sfambach/XT-AT-PC-RGB-LED/hardware/v2/v2-bottom.png

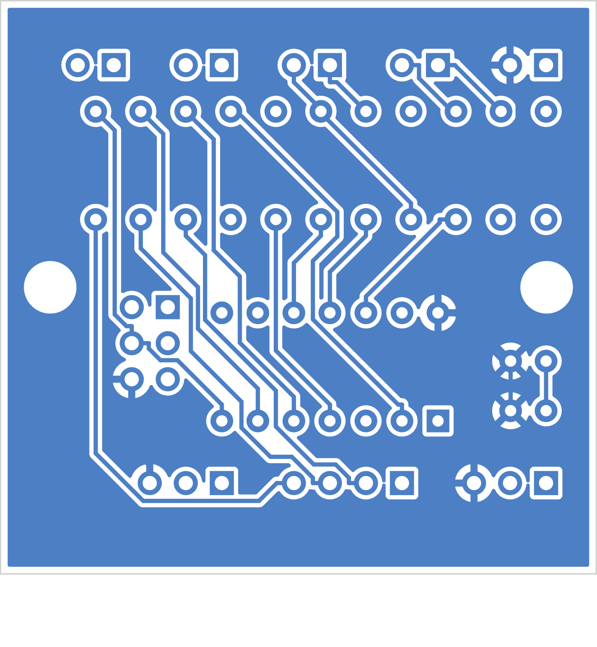
hardware/v2/v2-bottom.png
