sfambach/XT-AT-PC-RGB-LED/hardware/v2/v2-top.png

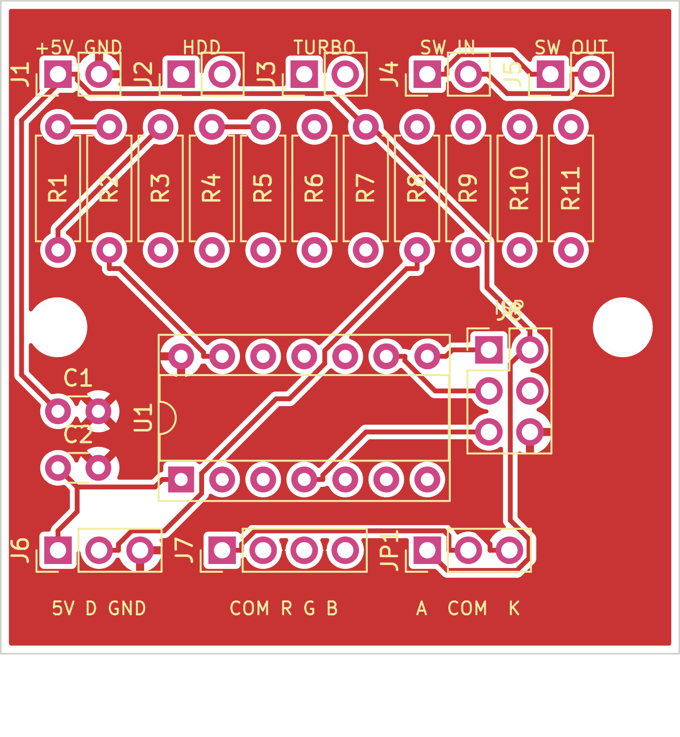
hardware/v2/v2-top.png
