sfambach/XT-AT-PC-RGB-LED/sim/three_states_tran.png

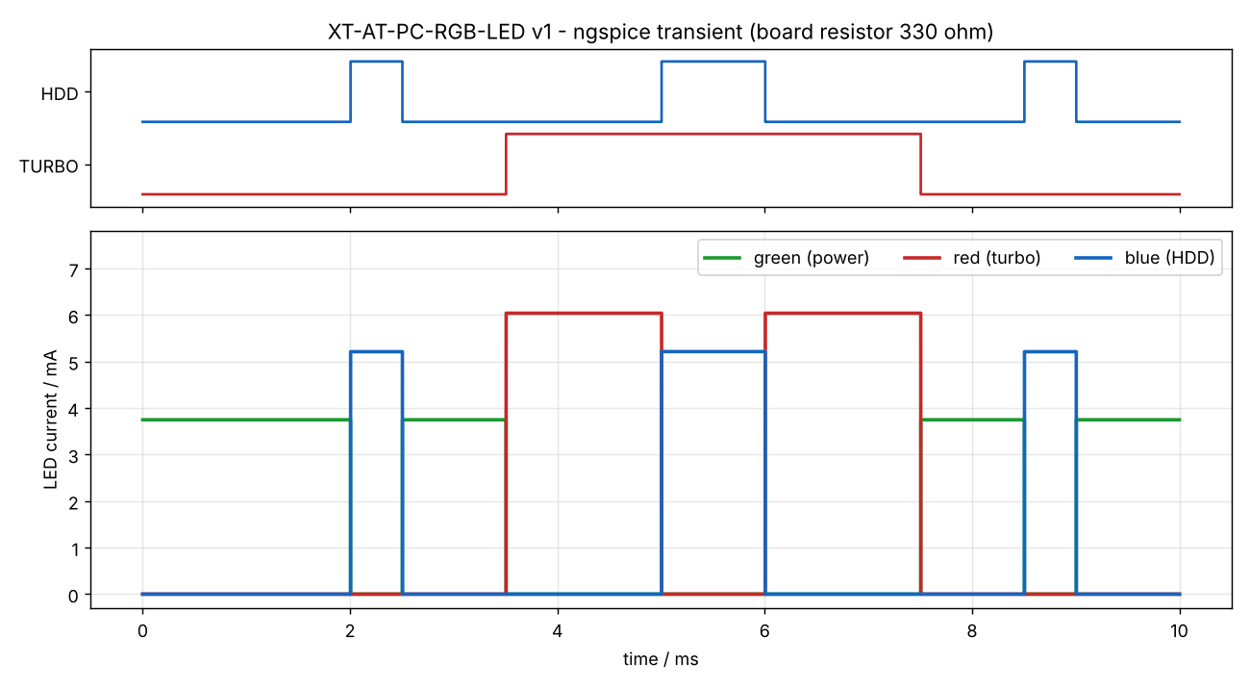
sim/three_states_tran.png
