sfambach/XT-AT-PC-RGB-LED/hardware/v2/xt-at-pc-rgb-led-v2-schematic.pdf

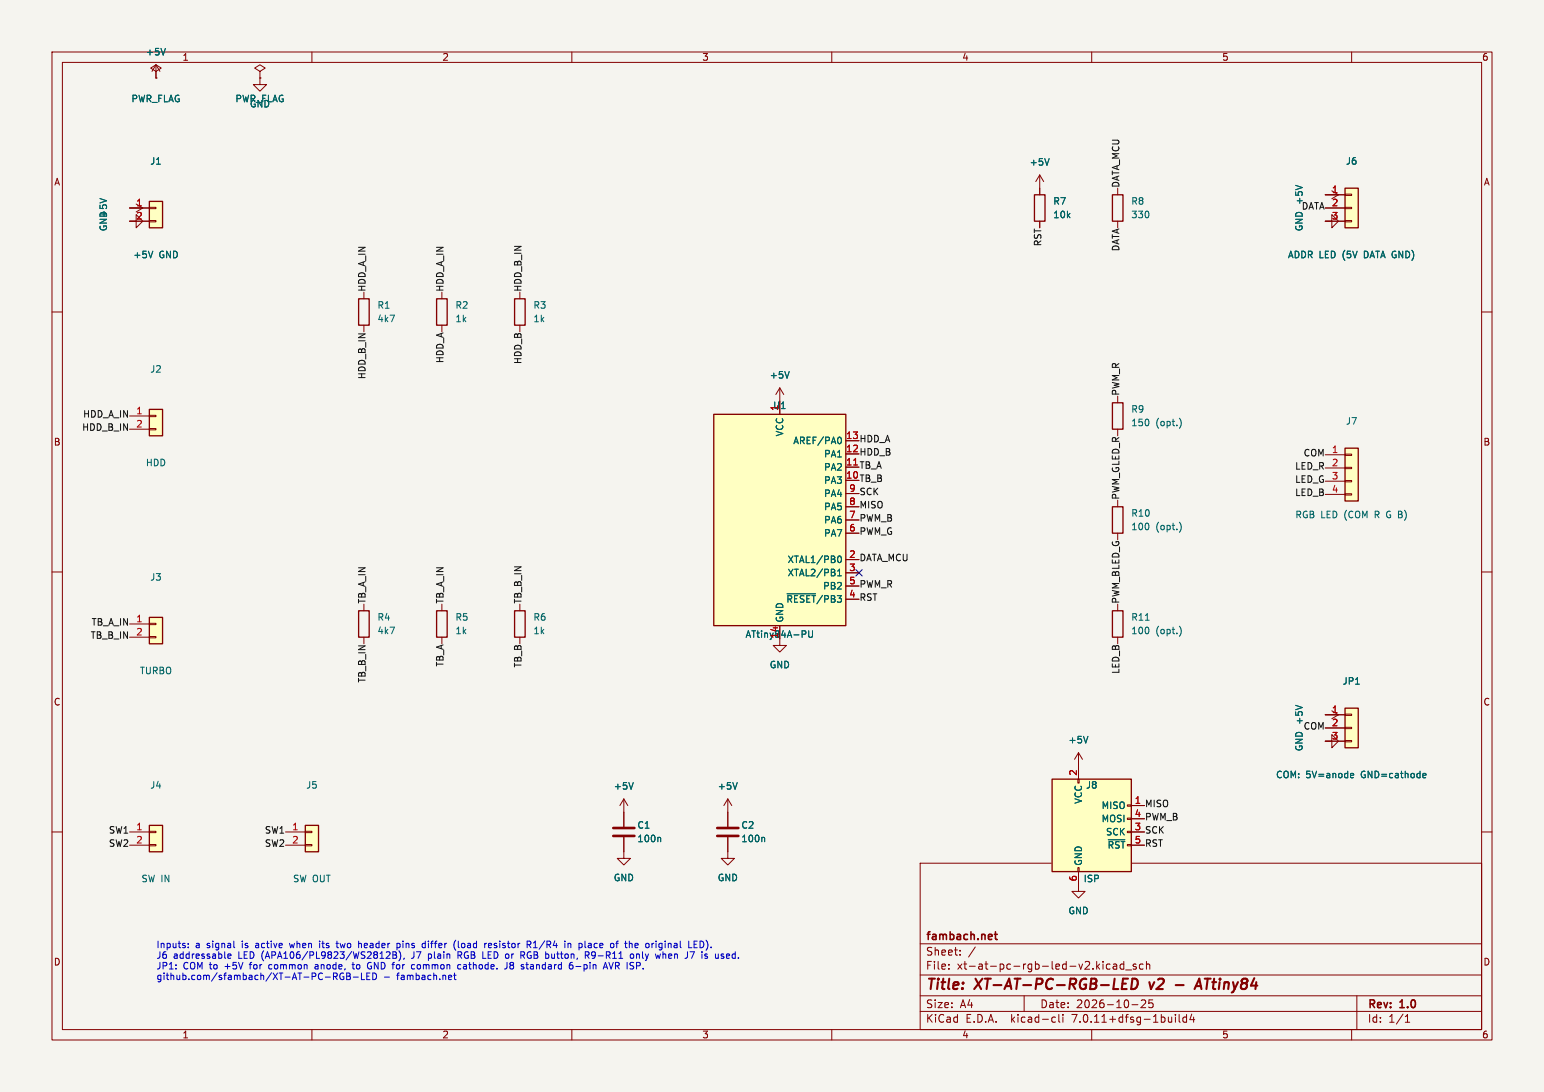
[picture p7: page 1]

J6 ADDR LED (5V DATA GND) +5V GND

J6 ADDR LED (5V DATA GND) 1

U1 ATtiny84A-PU VCC
File: xt-at-pc-rgb-led-v2.kicad_sch Sheet: / fambach.net VCC
TB_A HDD_B DATA_MCU

1 PA3 10 PA2 11 PA1 12 AREF/PA0 13 GND 14 XTAL1/PB0 2 XTAL2/PB1 3 ~{RESET}/PB34 PB2 5 PA7 6 PA6 7 PA5 8 PA4 9 U1 ATtiny84A-PU

2 SCK 3 MOSI 4 ~{RST}5 GND
ISP MISO VCC
