sfambach/XT-AT-PC-RGB-LED/hardware/v1/xt-at-pc-rgb-led-v1-schematic.pdf

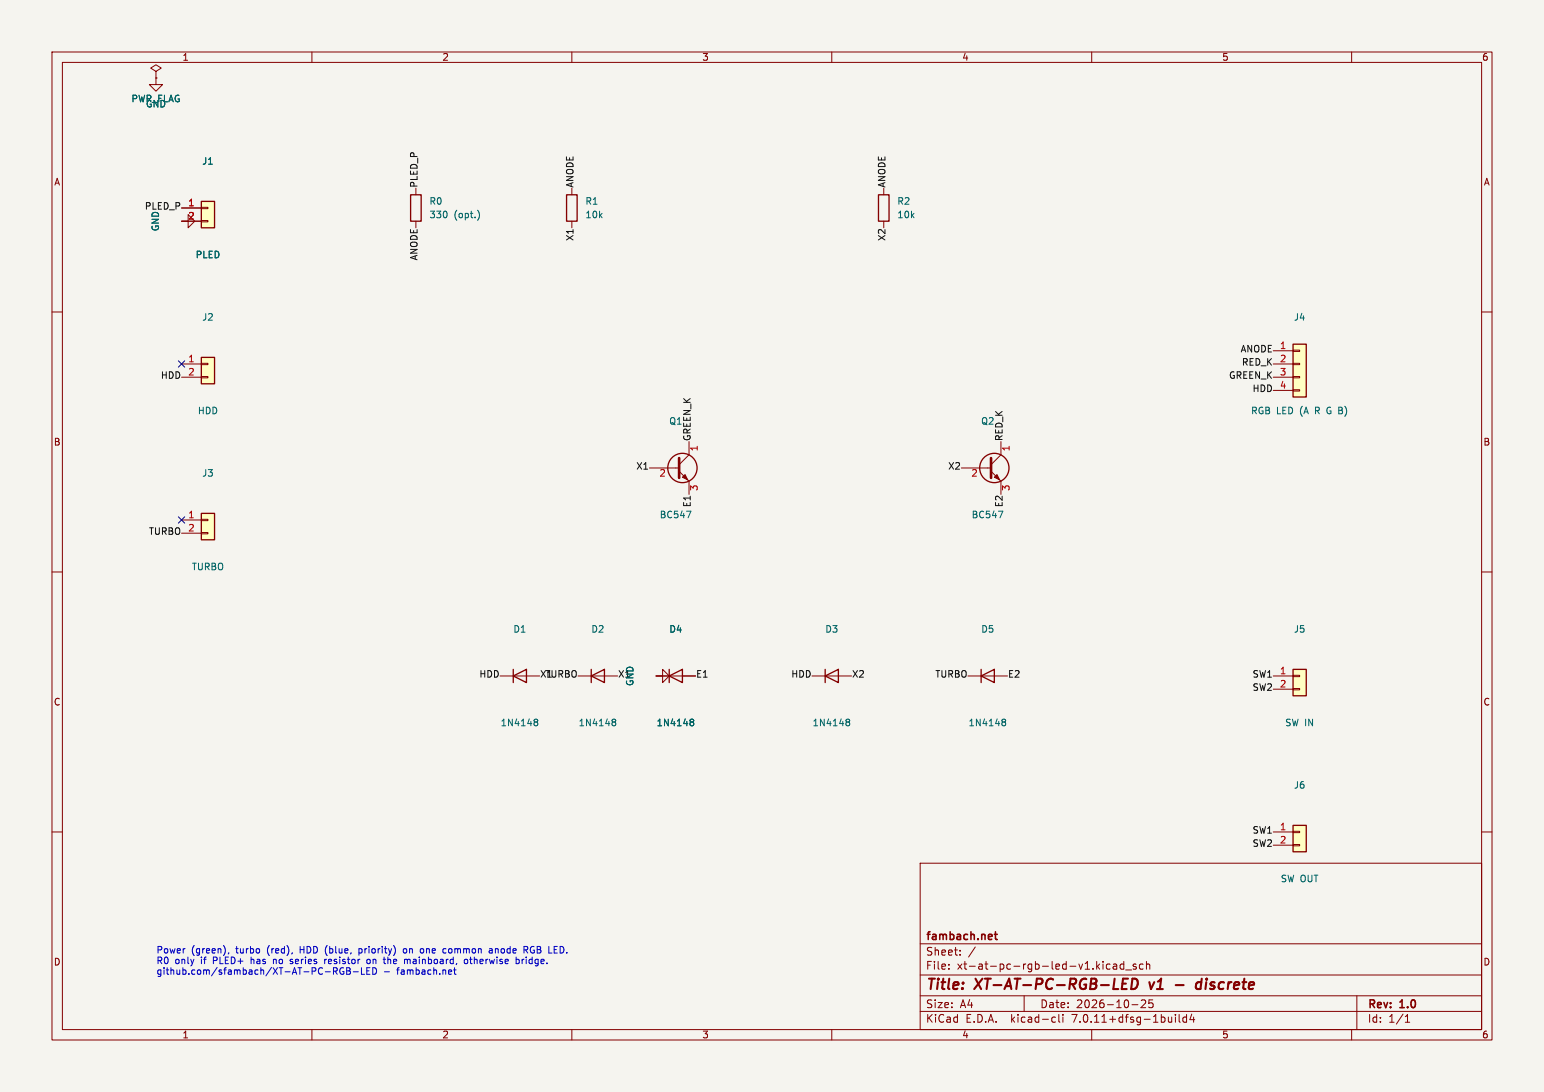
[picture p8: page 1]

File: xt-at-pc-rgb-led-v1.kicad_sch Sheet: / fambach.net D3
