sfambach/XT-AT-PC-RGB-LED/hardware/v2/xt-at-pc-rgb-led-v2.kicad_pcb

## KiCad design hardware/v2/xt-at-pc-rgb-led-v2.kicad_pcb (2026-10-25)

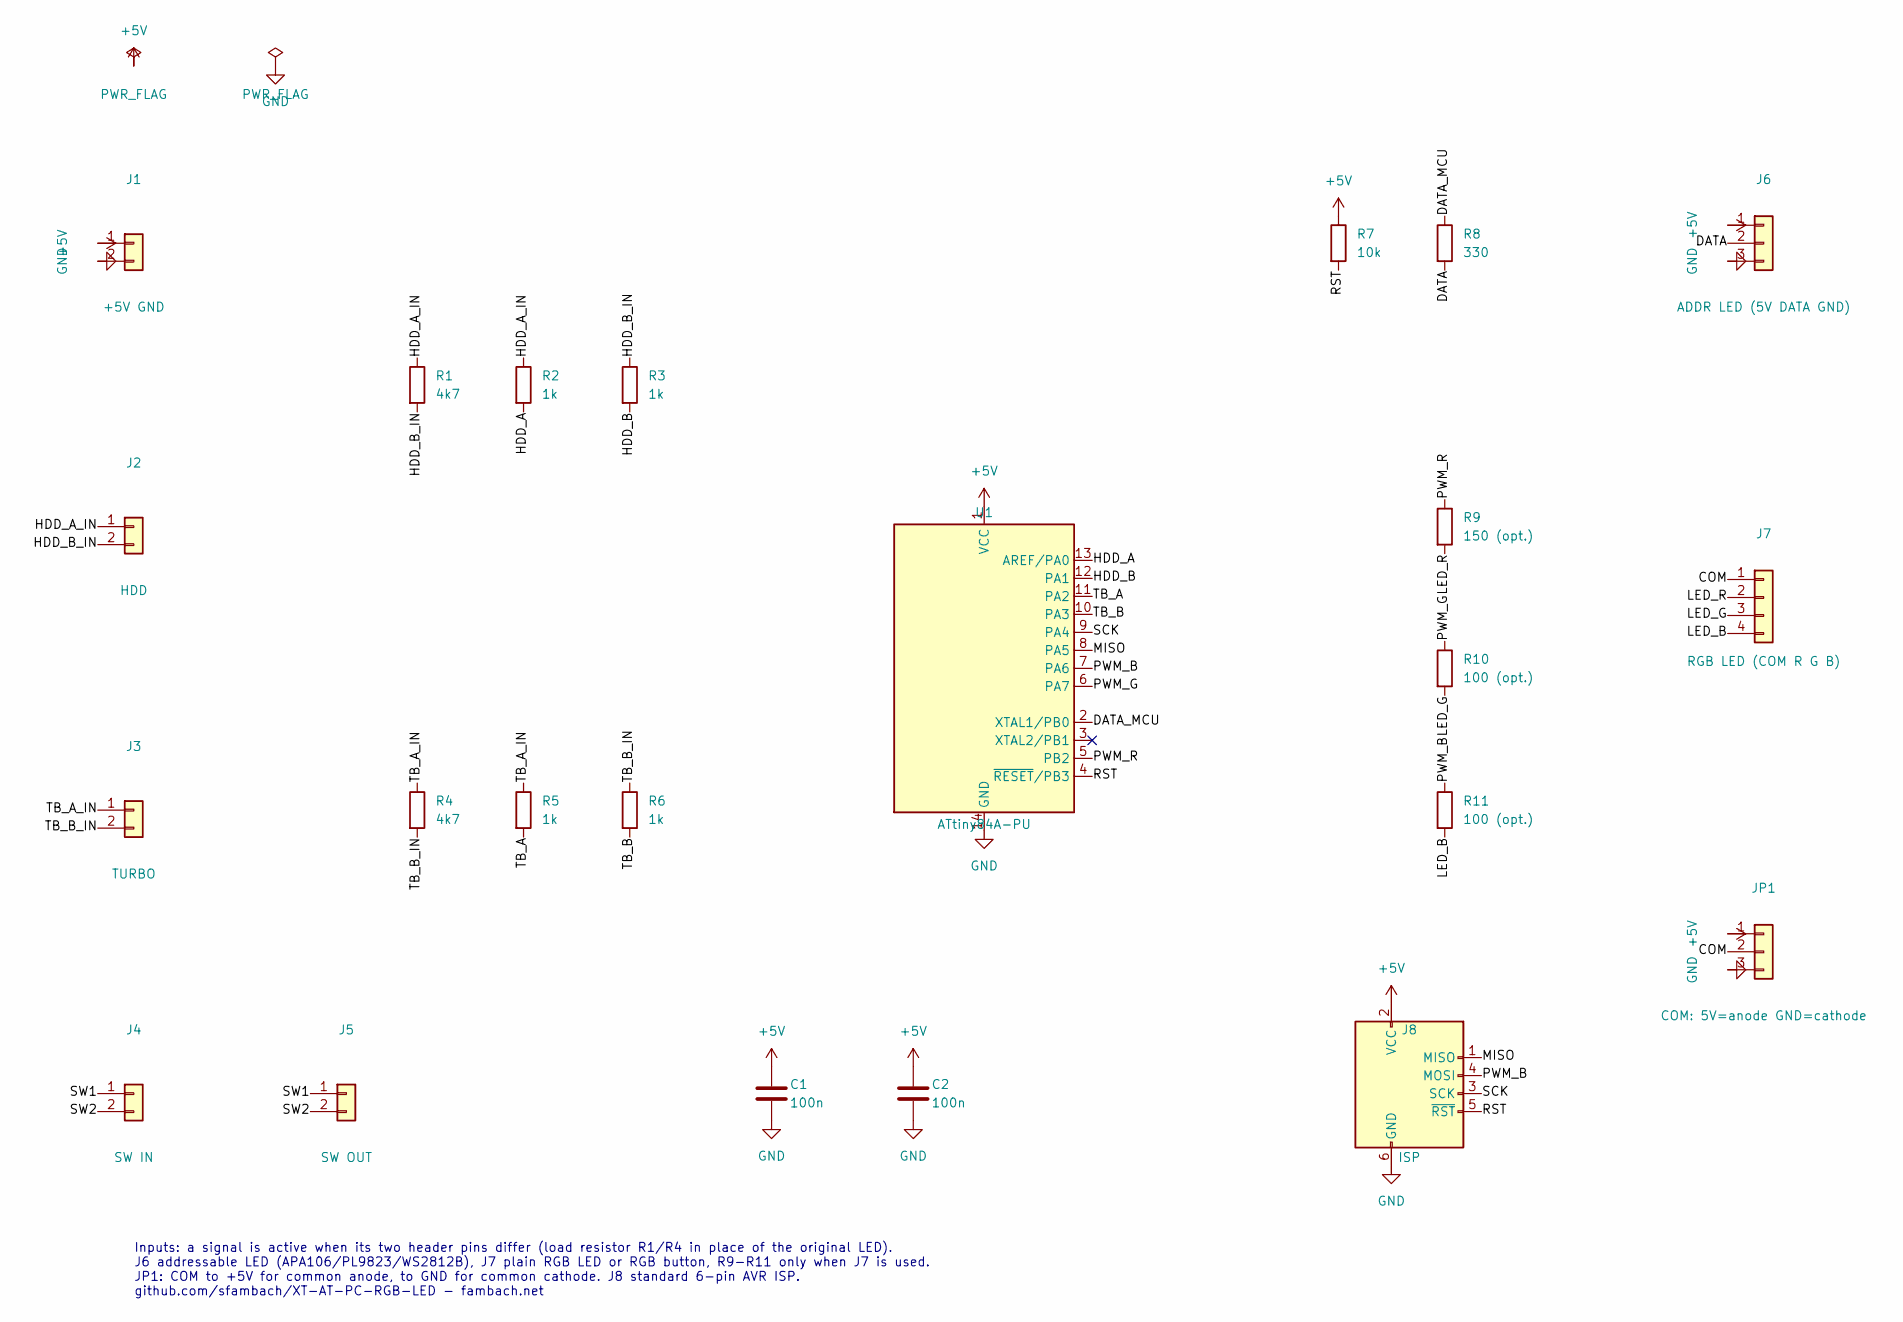
[picture p9: schematic xt-at-pc-rgb-led-v2.kicad_sch, XT-AT-PC-RGB-LED v2 - ATtiny84]

Parts:
C1, C2: 100n; C_Disc_D3.0mm_W1.6mm_P2.50mm
J1: +5V GND; PinHeader_1x02_P2.54mm_Vertical
J2: HDD; PinHeader_1x02_P2.54mm_Vertical
J3: TURBO; PinHeader_1x02_P2.54mm_Vertical
J4: SW IN; PinHeader_1x02_P2.54mm_Vertical
J5: SW OUT; PinHeader_1x02_P2.54mm_Vertical
J6: ADDR LED (5V DATA GND); PinHeader_1x03_P2.54mm_Vertical
J7: RGB LED (COM R G B); PinHeader_1x04_P2.54mm_Vertical
J8: ISP; PinHeader_2x03_P2.54mm_Vertical
JP1: COM: 5V=anode GND=cathode; PinHeader_1x03_P2.54mm_Vertical
R1, R4: 4k7; R_Axial_DIN0207_L6.3mm_D2.5mm_P7.62mm_Horizontal
R2, R3, R5, R6: 1k; R_Axial_DIN0207_L6.3mm_D2.5mm_P7.62mm_Horizontal
R7: 10k; R_Axial_DIN0207_L6.3mm_D2.5mm_P7.62mm_Horizontal
R8: 330; R_Axial_DIN0207_L6.3mm_D2.5mm_P7.62mm_Horizontal
R9: 150 (opt.); R_Axial_DIN0207_L6.3mm_D2.5mm_P7.62mm_Horizontal
R10, R11: 100 (opt.); R_Axial_DIN0207_L6.3mm_D2.5mm_P7.62mm_Horizontal
U1: ATtiny84A-PU; DIP-14_W7.62mm_Socket

Connections:
+5V: C1.1, C2.1, J1.1, J6.1, J8.2 (VCC), JP1.1, R7.1, U1.1 (VCC)
/COM: J7.1, JP1.2
/DATA: J6.2, R8.2
/DATA_MCU: R8.1, U1.2 (XTAL1/PB0)
/HDD_A: R2.2, U1.13 (AREF/PA0)
/HDD_A_IN: J2.1, R1.1, R2.1
/HDD_B: R3.2, U1.12 (PA1)
/HDD_B_IN: J2.2, R1.2, R3.1
/LED_B: J7.4, R11.2
/LED_G: J7.3, R10.2
/LED_R: J7.2, R9.2
/MISO: J8.1 (MISO), U1.8 (PA5)
/PWM_B: J8.4 (MOSI), R11.1, U1.7 (PA6)
/PWM_G: R10.1, U1.6 (PA7)
/PWM_R: R9.1, U1.5 (PB2)
/RST: J8.5 (~RST), R7.2, U1.4 (~RESET/PB3)
/SCK: J8.3 (SCK), U1.9 (PA4)
/SW1: J4.1, J5.1
/SW2: J4.2, J5.2
/TB_A: R5.2, U1.11 (PA2)
/TB_A_IN: J3.1, R4.1, R5.1
/TB_B: R6.2, U1.10 (PA3)
/TB_B_IN: J3.2, R4.2, R6.1
GND: C1.2, C2.2, J1.2, J6.3, J8.6 (GND), JP1.3, U1.14 (GND)

Notes on the sheet:
Inputs: a signal is active when its two header pins differ (load resistor R1/R4 in place of the original LED). J6 addressable LED (APA106/PL9823/WS2812B), J7 plain RGB LED or RGB button, R9-R11 only when J7 is used. JP1: COM to +5V for common anode, to GND for common cathode. J8 standard 6-pin AVR 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

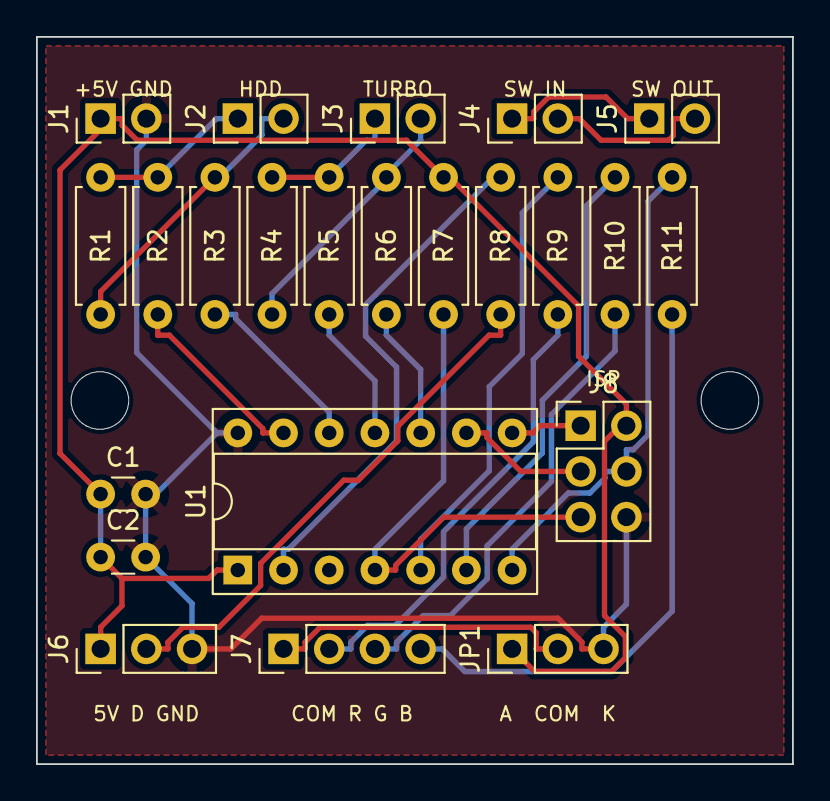
[picture p10: board xt-at-pc-rgb-led-v2.kicad_pcb from above]

Board: 2 copper layers, 42.0 x 40.4 mm, 25 parts (0 on the bottom side), 24 nets.

Other parts of the board:
H1, H2: M3; MountingHole_3.2mm_M3
