sfambach/XT-AT-PC-RGB-LED/hardware/v1/xt-at-pc-rgb-led-v1.kicad_pcb

## KiCad design hardware/v1/xt-at-pc-rgb-led-v1.kicad_pcb (2026-10-25, an earlier design)

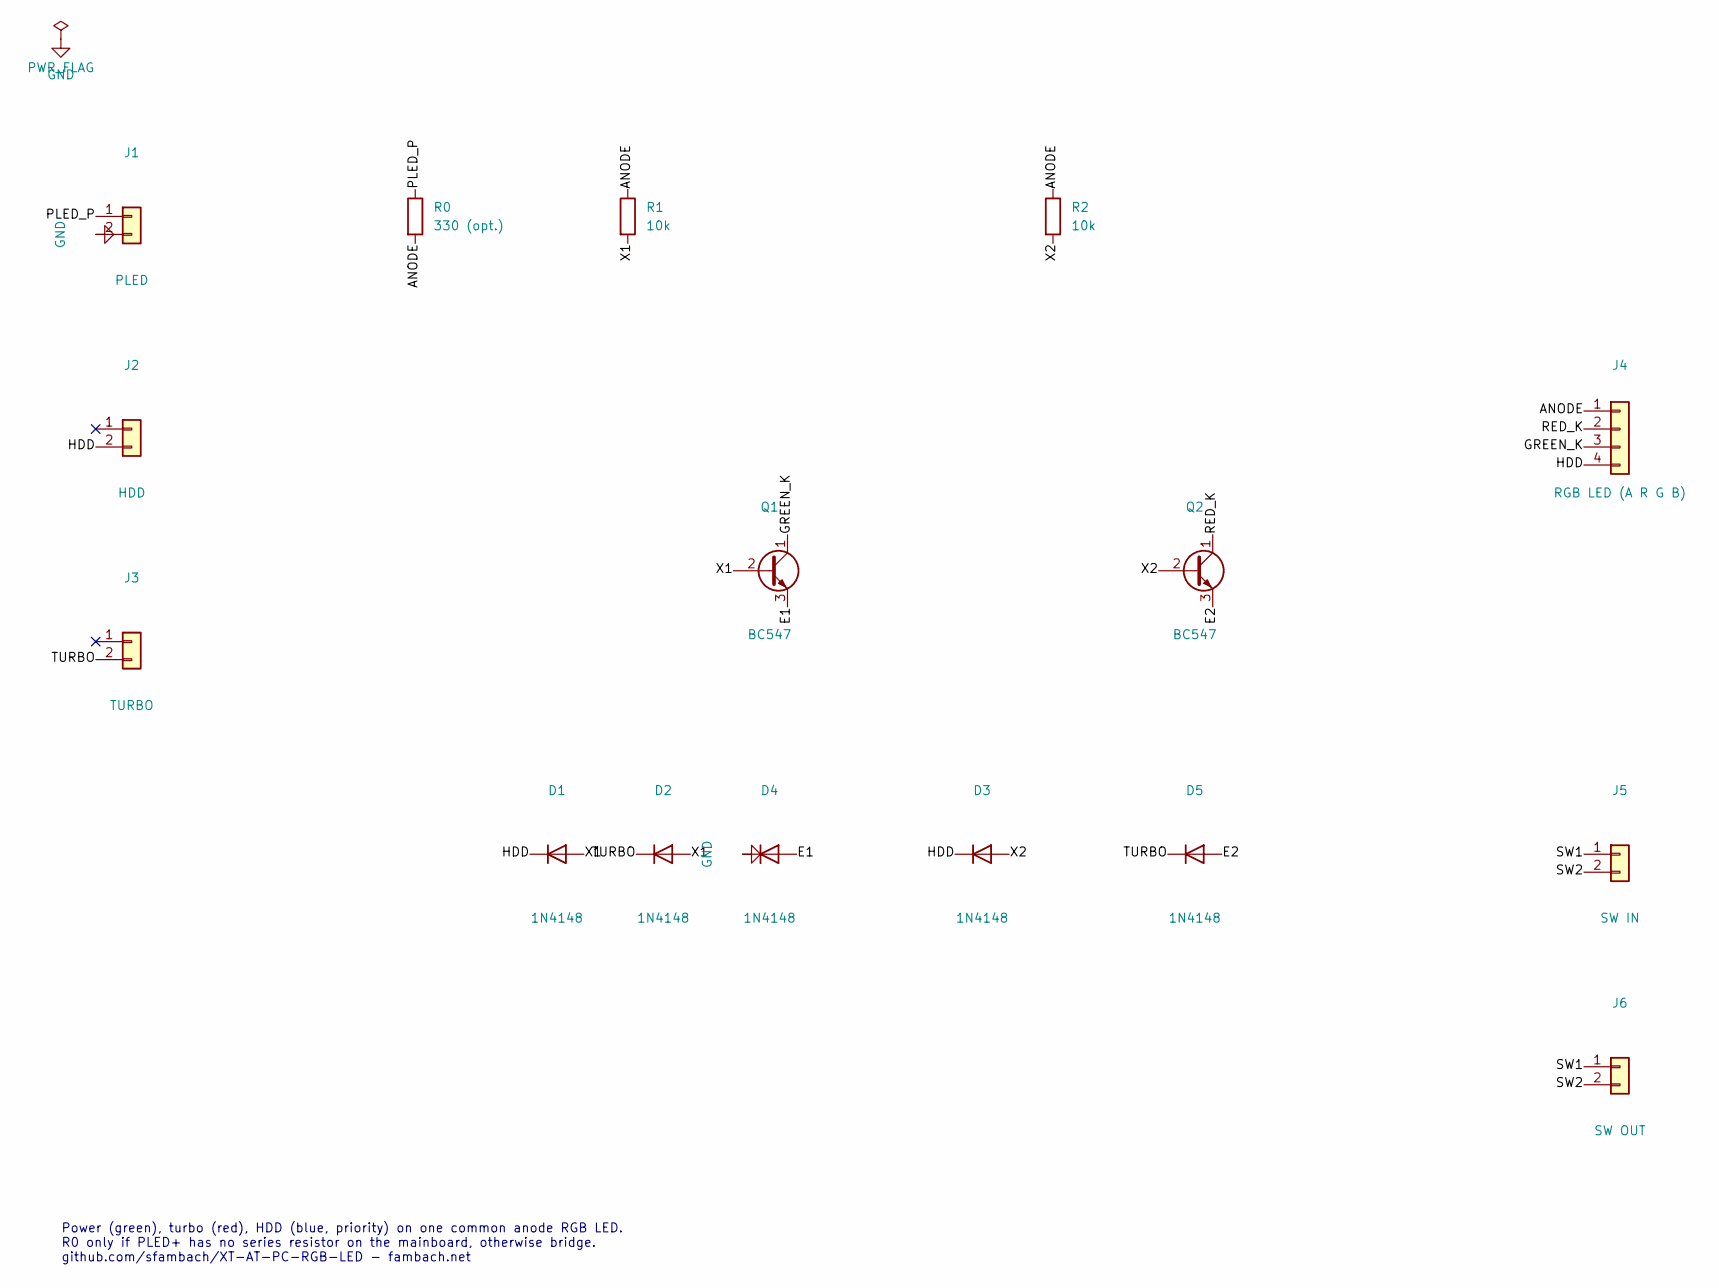
[picture p11: schematic xt-at-pc-rgb-led-v1.kicad_sch, XT-AT-PC-RGB-LED v1 - discrete]

Parts:
D1, D2, D3, D4, D5: 1N4148; D_DO-35_SOD27_P7.62mm_Horizontal
J1: PLED; PinHeader_1x02_P2.54mm_Vertical
J2: HDD; PinHeader_1x02_P2.54mm_Vertical
J3: TURBO; PinHeader_1x02_P2.54mm_Vertical
J4: RGB LED (A R G B); PinHeader_1x04_P2.54mm_Vertical
J5: SW IN; PinHeader_1x02_P2.54mm_Vertical
J6: SW OUT; PinHeader_1x02_P2.54mm_Vertical
Q1, Q2: BC547; TO-92_Inline_Wide
R0: 330 (opt.); R_Axial_DIN0207_L6.3mm_D2.5mm_P7.62mm_Horizontal
R1, R2: 10k; R_Axial_DIN0207_L6.3mm_D2.5mm_P7.62mm_Horizontal

Connections:
/ANODE: J4.1, R0.2, R1.1, R2.1
/E1: D4.2 (A), Q1.3 (E)
/E2: D5.2 (A), Q2.3 (E)
/GREEN_K: J4.3, Q1.1 (C)
/HDD: D1.1 (K), D3.1 (K), J2.2, J4.4
/PLED_P: J1.1, R0.1
/RED_K: J4.2, Q2.1 (C)
/SW1: J5.1, J6.1
/SW2: J5.2, J6.2
/TURBO: D2.1 (K), D5.1 (K), J3.2
/X1: D1.2 (A), D2.2 (A), Q1.2 (B), R1.2
/X2: D3.2 (A), Q2.2 (B), R2.2
GND: D4.1 (K), J1.2

Notes on the sheet:
Power (green), turbo (red), HDD (blue, priority) on one common anode RGB LED. R0 only if PLED+ has no series resistor on the mainboard, otherwise bridge. github.com/sfambach/XT-AT-PC-RGB-LED - fambach.net

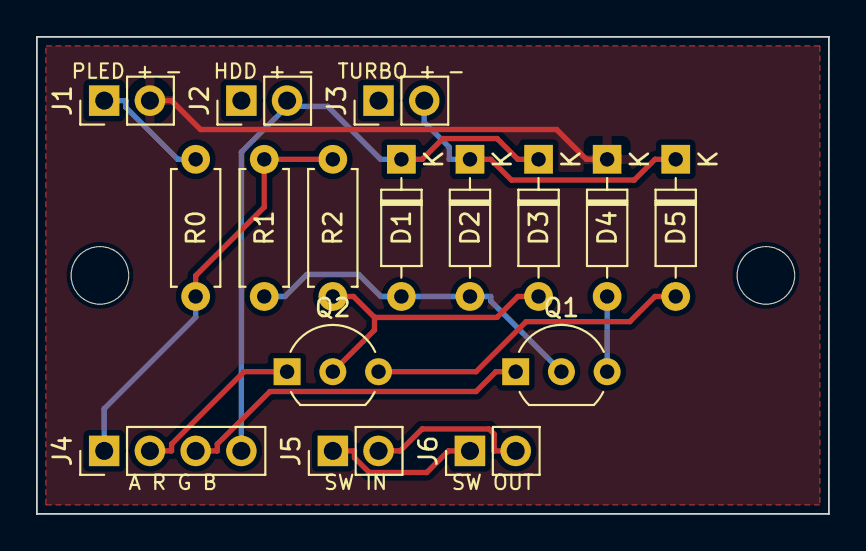
[picture p12: board xt-at-pc-rgb-led-v1.kicad_pcb from above]

Board: 2 copper layers, 44.0 x 26.5 mm, 18 parts (0 on the bottom side), 13 nets.

Other parts of the board:
H1, H2: M3; MountingHole_3.2mm_M3
