sfambach/XT-AT-PC-RGB-LED/(commit log)

2026-10-25 Add RGB status LED v1 circuit and v2 ATtiny85 firmware
    v1: one common anode RGB LED for power (green), turbo (red) and HDD
    (blue, priority) with two NPN transistors, five diodes and two resistors,
    ngspice simulations included.
    v2: ATtiny85 driving an addressable RGB LED, polarity independent header
    inputs, EEPROM configuration built from config.ini.
    Claude-Session: https://claude.ai/code/session_01JRatMm8Q7Nvo5CN8dD4gBk
2026-10-25 v2: add plain RGB output (ATtiny84 PWM) and switch notes
    ATtiny84 build drives an addressable LED and a plain common anode or
    common cathode RGB LED / RGB button at the same time. Config version 2
    adds rgb_output. README describes both LED outputs, button vs. latching
    switch (ATX, ATX-to-AT adapter) and the ATtiny84 pinout.
    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
2026-10-25 Add v1 and v2 boards, transient simulation
    KiCad 7 boards generated from Python (hardware/generator), routed with
    Freerouting: v1 discrete 48 x 22.5 mm, v2 ATtiny84 DIP-14 with 6-pin
    AVR ISP, addressable and plain RGB output, 54.5 x 33 mm. Both with two
    M3 holes on the long axis. Gerber, schematic PDF, renders and DRC
    reports included. Transient ngspice simulation with plot script.
    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
    [xt-at-pc-rgb-led-v1.kicad_pcb, xt-at-pc-rgb-led-v1.kicad_sch, xt-at-pc-rgb-led-v2.kicad_pcb, xt-at-pc-rgb-led-v2.kicad_sch]
2026-10-25 Add 2D dimension drawings and project history
    Top, front and side view per board, generated from the PCB, with the
    assumed component heights stated. README gets a short history with the
    key decisions.
    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
2026-10-25 v2: mounting holes between parts, board 42.5 x 33 mm
    C2 and R11 moved so the M3 holes fit between the parts; board width
    54.5 -> 42.5 mm. Dimension drawings assume standing resistors (about
    11 mm height).
    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
    [xt-at-pc-rgb-led-v2.kicad_pcb, xt-at-pc-rgb-led-v2.kicad_sch]
2026-10-25 Lay resistors and diodes flat on both boards
    7.62 mm horizontal footprints, side by side; mounting holes in gaps
    between the parts. v1 44 x 25.5 mm, v2 42 x 36.4 mm. Component height
    about 8.5 mm.
    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
    [xt-at-pc-rgb-led-v1.kicad_pcb, xt-at-pc-rgb-led-v1.kicad_sch, xt-at-pc-rgb-led-v2.kicad_pcb, xt-at-pc-rgb-led-v2.kicad_sch]
2026-10-25 More margin above the top labels
    1 mm more board above the connector labels so the silkscreen fits;
    v1 44 x 26.5 mm, v2 42 x 38.4 mm (holes stay centred).
    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
    [xt-at-pc-rgb-led-v1.kicad_pcb, xt-at-pc-rgb-led-v1.kicad_sch, xt-at-pc-rgb-led-v2.kicad_pcb, xt-at-pc-rgb-led-v2.kicad_sch]
2026-10-25 Resistor and diode references inside the body outline
    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
    [xt-at-pc-rgb-led-v1.kicad_pcb, xt-at-pc-rgb-led-v1.kicad_sch, xt-at-pc-rgb-led-v2.kicad_pcb, xt-at-pc-rgb-led-v2.kicad_sch]
2026-10-25 v2: more margin, lower bottom labels; references along the parts
    v2 42 x 40.4 mm: 1 mm more above the top labels, bottom connector
    labels 2 mm lower. Resistor and diode references run along the body
    on both boards.
    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
    [xt-at-pc-rgb-led-v1.kicad_pcb, xt-at-pc-rgb-led-v1.kicad_sch, xt-at-pc-rgb-led-v2.kicad_pcb, xt-at-pc-rgb-led-v2.kicad_sch]
