sfambach/XT-AT-PC-RGB-LED/(notices)

Notices in the files:
hardware/v1/xt-at-pc-rgb-led-v1.kicad_pcb:
XT-AT-PC-RGB-LED v1 - fambach.net - CERN-OHL-S-2.0
hardware/v2/xt-at-pc-rgb-led-v2.kicad_pcb:
XT-AT-PC-RGB-LED v2 - fambach.net - CERN-OHL-S-2.0
